paulschow/epapercard/README.md

# epapercard
Design for a epaper business card

Project writeup http://www.paulschow.com/2016/08/epaper-business-card.html

Based on the reference deisgns from http://repaper.org/

Requires MSP430 Launchpad to program.
