paulschow/epapercard/Brd_back_Aug14.png

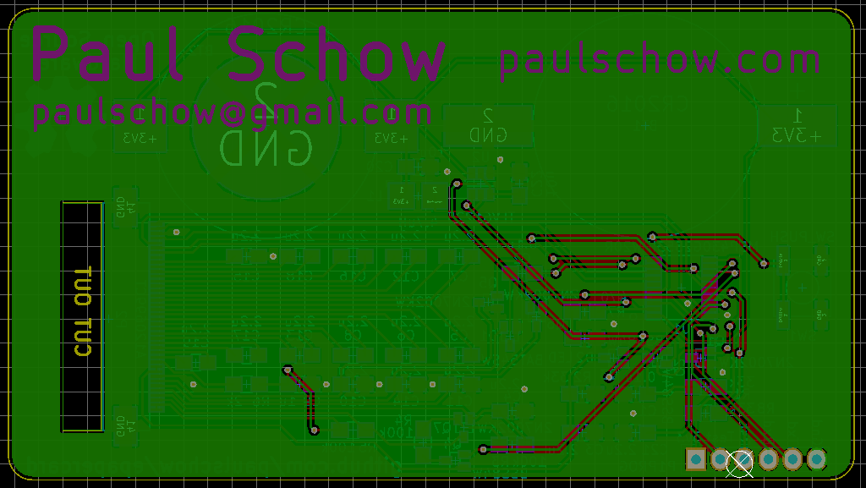
Brd_back_Aug14.png
