paulschow/epapercard/Brd_front_Aug14.png

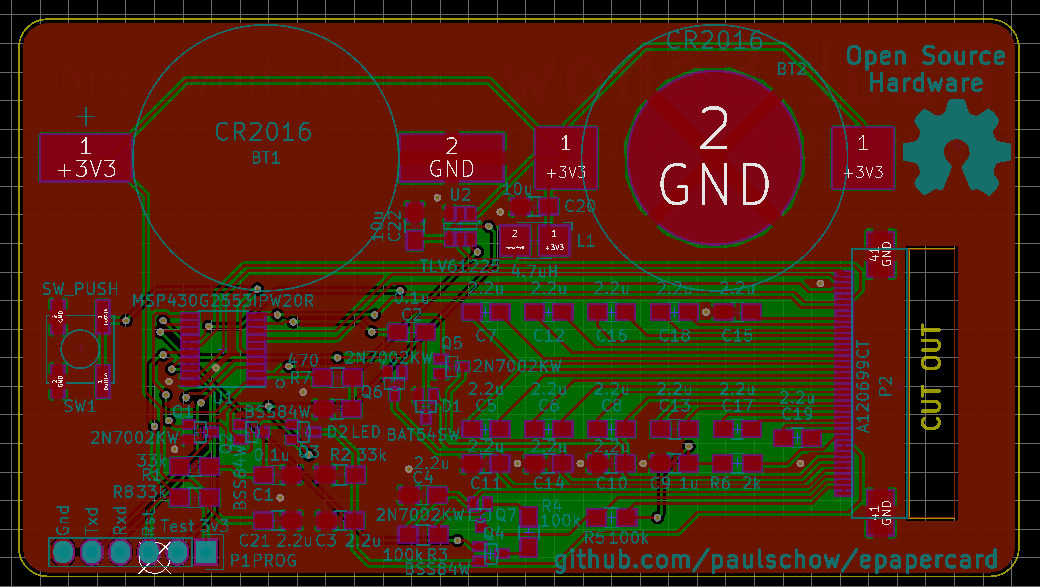
Brd_front_Aug14.png
