paulschow/epapercard/Sch_Aug_14.pdf

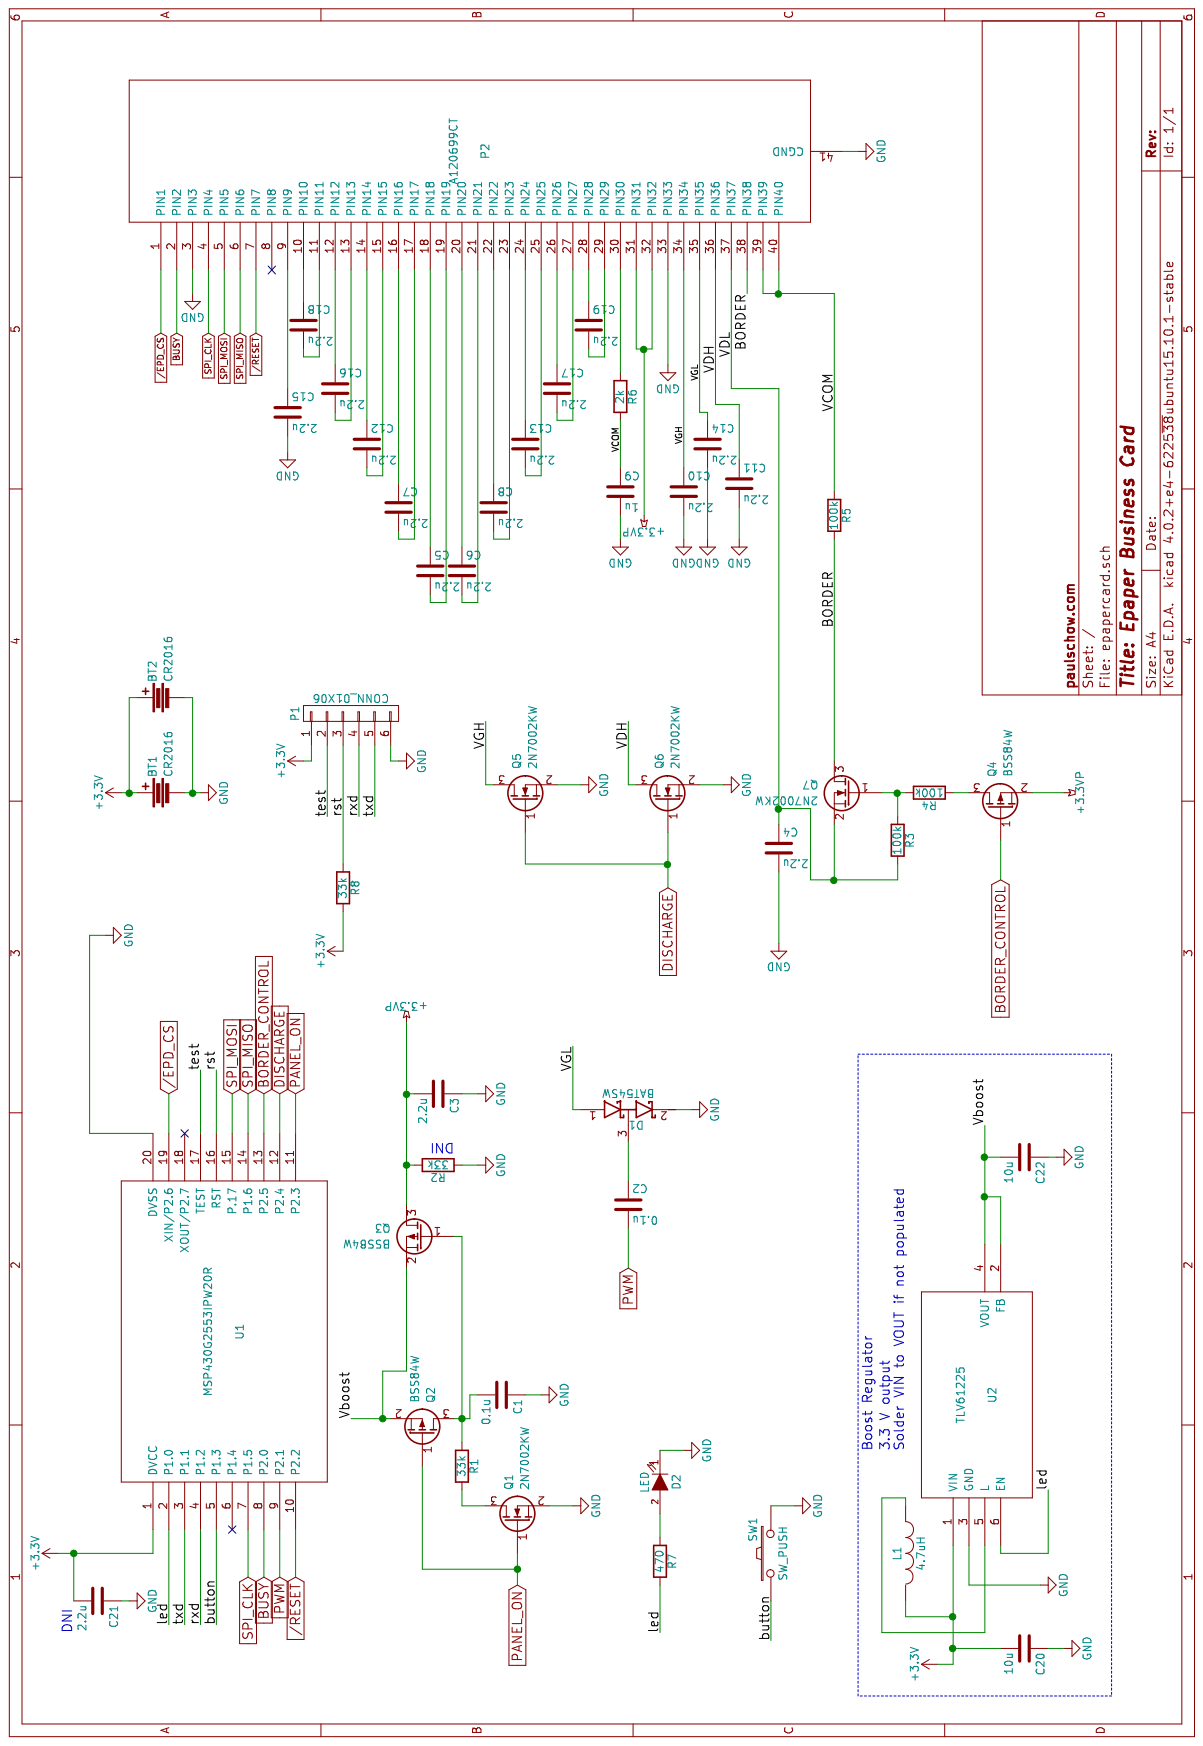
[picture p3: page 1]
