paulschow/epapercard/epapercard.kicad_pcb

## KiCad design epapercard.kicad_pcb (2016-08-05)

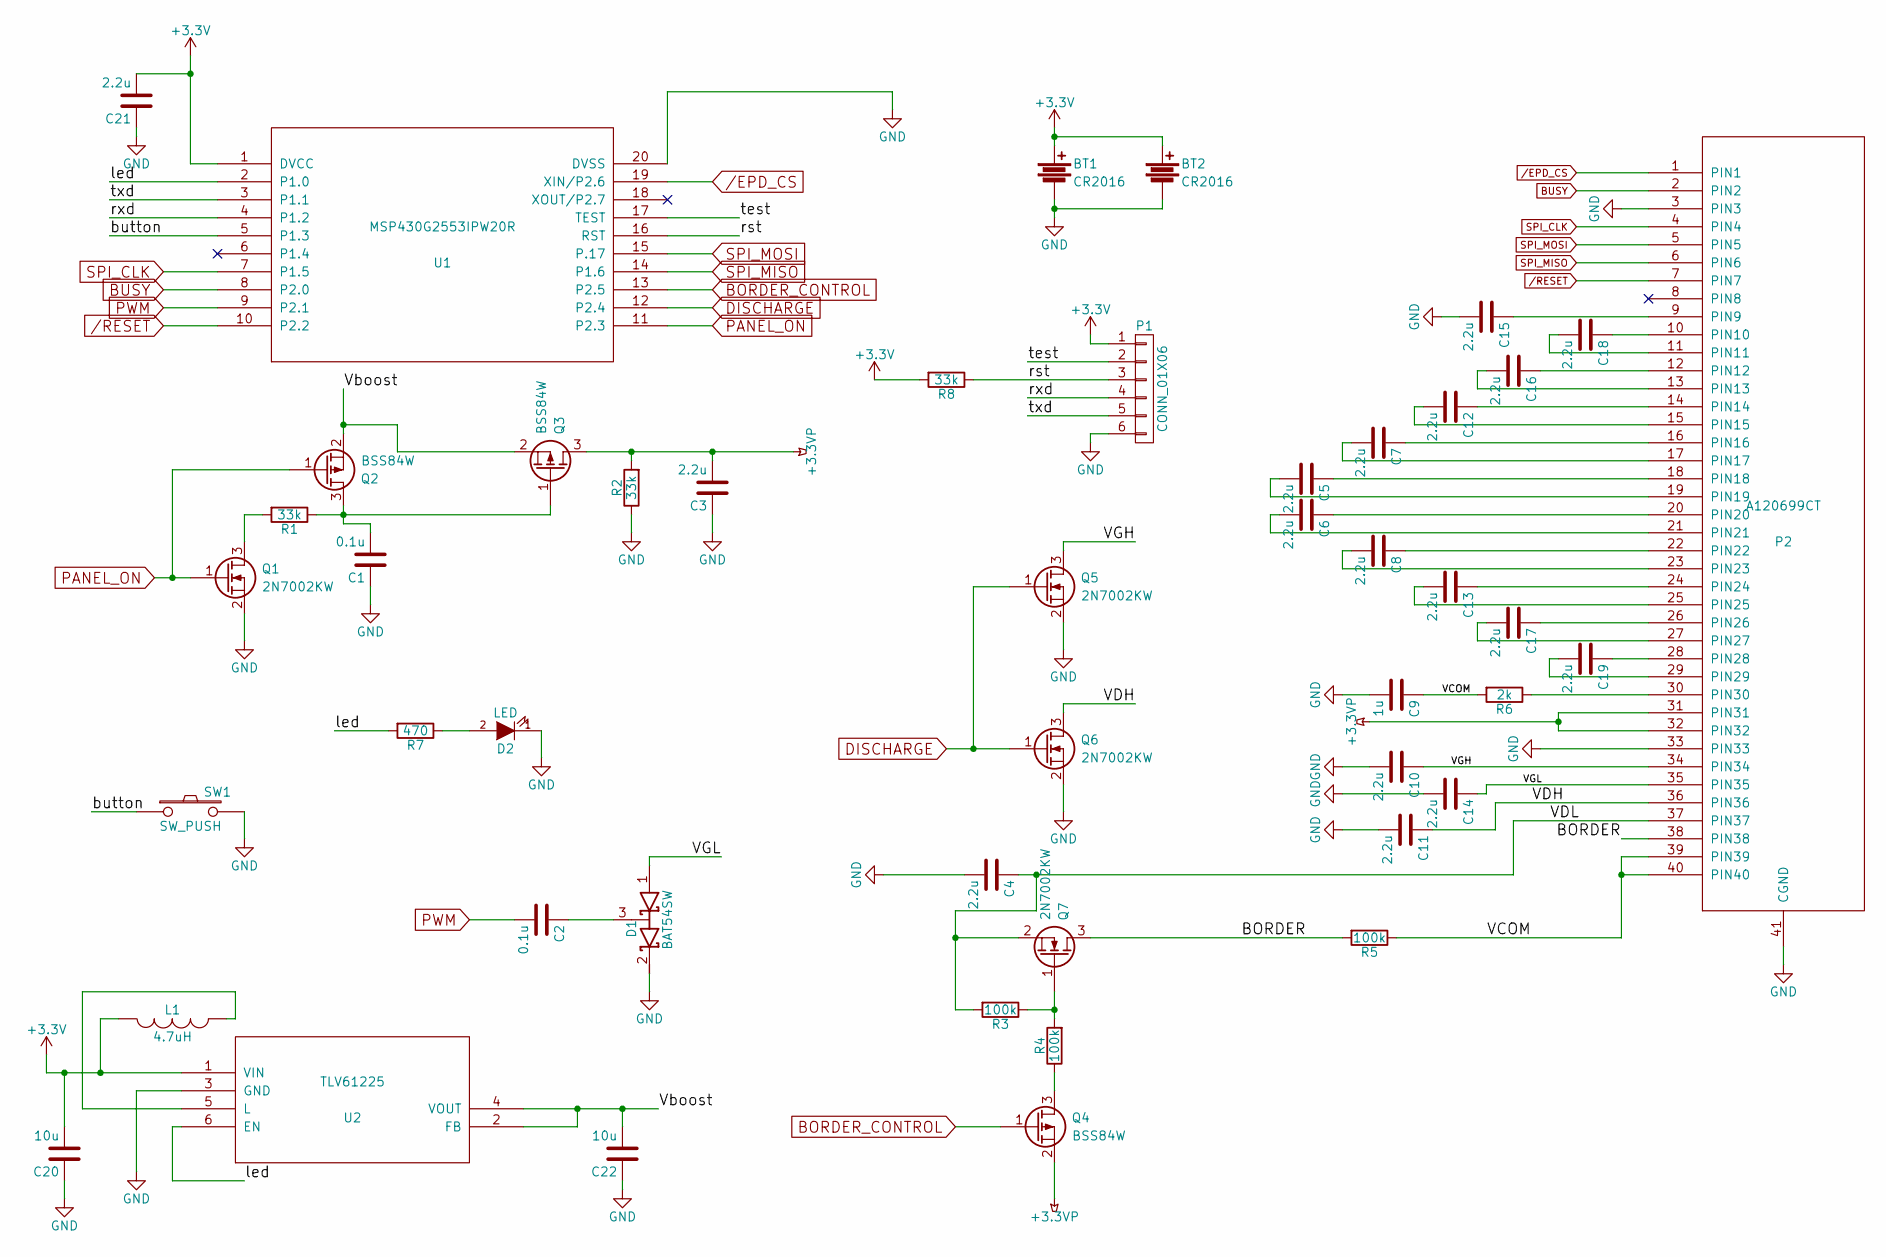
[picture p4: schematic epapercard.sch, Epaper Business Card]

Parts:
BT1: CR2016; CR2016sm-F2N
BT2: CR2016; CR2032sm
C1, C2: 0.1u; C_0805_HandSoldering
C3, C4, C5, C6, C7, C8, C10, C11, C12, C13, C14, C15, C16, C17, C18, C19, C21: 2.2u; C_0805_HandSoldering
C9: 1u; C_0805_HandSoldering
C20, C22: 10u; C_0805_HandSoldering
D1: BAT54SW; SOT-323
D2: LED; C_0805_HandSoldering
L1: 4.7uH; Inductor_1212
P1: CONN_01X06; Pin_Header_Straight_1x06
P2: A120699CT
Q1, Q5, Q6, Q7: 2N7002KW; SOT-323
Q2, Q3, Q4: BSS84W; SOT-323
R1, R2, R8: 33k; R_0805_HandSoldering
R3, R4, R5: 100k; R_0805_HandSoldering
R6: 2k; R_0805_HandSoldering
R7: 470; R_0805_HandSoldering
SW1: SW_PUSH; SW_SPST_EVPBF
U1: MSP430G2553IPW20R; TSSOP-20_4.4x6.5mm_Pitch0.65mm
U2: TLV61225; SOT-23-6

Connections:
+3.3VP: C3.2, P2.31 (PIN31), P2.32 (PIN32), Q3.3 (D), Q4.2 (S), R2.2
+3V3: BT1.1, BT2.1, C20.2, C21.2, L1.1, P1.1, R8.2, U1.1 (DVCC), U2.1 (VIN)
/BORDER: P2.38 (PIN38), Q7.3 (D), R5.2
/EPD_CS: P2.1 (PIN1), U1.19 (XIN/P2.6)
/RESET: P2.7 (PIN7), U1.10 (P2.2)
/VCOM: C9.1, P2.39 (PIN39), P2.40 (PIN40), R5.1, R6.2
/VDH: C11.1, P2.36 (PIN36), Q6.3 (D)
/VDL: C4.1, P2.37 (PIN37), Q7.2 (S), R3.2
/VGH: C10.1, P2.34 (PIN34), Q5.3 (D)
/VGL: C14.1, D1.1 (A), P2.35 (PIN35)
/Vboost: C22.2, Q2.2 (S), Q3.2 (S), U2.2 (FB), U2.4 (VOUT)
/button: SW1.1, U1.5 (P1.3)
/led: R7.2, U1.2 (P1.0), U2.6 (EN)
/rst: P1.3, R8.1, U1.16 (RST)
/rxd: P1.4, U1.4 (P1.2)
/test: P1.2, U1.17 (TEST)
/txd: P1.5, U1.3 (P1.1)
BORDER_CONTROL: Q4.1 (G), U1.13 (P2.5)
BUSY: P2.2 (PIN2), U1.8 (P2.0)
DISCHARGE: Q5.1 (G), Q6.1 (G), U1.12 (P2.4)
GND: BT1.2, BT2.2, C1.1, C3.1, C4.2, C9.2, C10.2, C11.2, C14.2, C15.2, C20.1, C21.1, C22.1, D1.2 (K), D2.1 (K), P1.6, P2.3 (PIN3), P2.33 (PIN33), P2.41 (CGND), Q1.2 (S), Q5.2 (S), Q6.2 (S), R2.1, SW1.2, U1.20 (DVSS), U2.3 (GND)
unnamed: C1.2, Q2.3 (D), Q3.1 (G), R1.1
unnamed: C2.1, D1.3 (common)
unnamed: C5.1, P2.18 (PIN18)
unnamed: C5.2, P2.19 (PIN19)
unnamed: C6.1, P2.20 (PIN20)
unnamed: C6.2, P2.21 (PIN21)
unnamed: C7.1, P2.16 (PIN16)
unnamed: C7.2, P2.17 (PIN17)
unnamed: C8.1, P2.22 (PIN22)
unnamed: C8.2, P2.23 (PIN23)
unnamed: C12.1, P2.14 (PIN14)
unnamed: C12.2, P2.15 (PIN15)
unnamed: C13.1, P2.24 (PIN24)
unnamed: C13.2, P2.25 (PIN25)
unnamed: C15.1, P2.9 (PIN9)
unnamed: C16.1, P2.12 (PIN12)
unnamed: C16.2, P2.13 (PIN13)
unnamed: C17.1, P2.26 (PIN26)
unnamed: C17.2, P2.27 (PIN27)
unnamed: C18.1, P2.10 (PIN10)
unnamed: C18.2, P2.11 (PIN11)
unnamed: C19.1, P2.28 (PIN28)
unnamed: C19.2, P2.29 (PIN29)
unnamed: D2.2 (A), R7.1
unnamed: L1.2, U2.5 (L)
unnamed: P2.30 (PIN30), R6.1
unnamed: Q1.3 (D), R1.2
unnamed: Q4.3 (D), R4.1
unnamed: Q7.1 (G), R3.1, R4.2
PANEL_ON: Q1.1 (G), Q2.1 (G), U1.11 (P2.3)
PWM: C2.2, U1.9 (P2.1)
SPI_CLK: P2.4 (PIN4), U1.7 (P1.5)
SPI_MISO: P2.6 (PIN6), U1.14 (P1.6)
SPI_MOSI: P2.5 (PIN5), U1.15 (P.17)

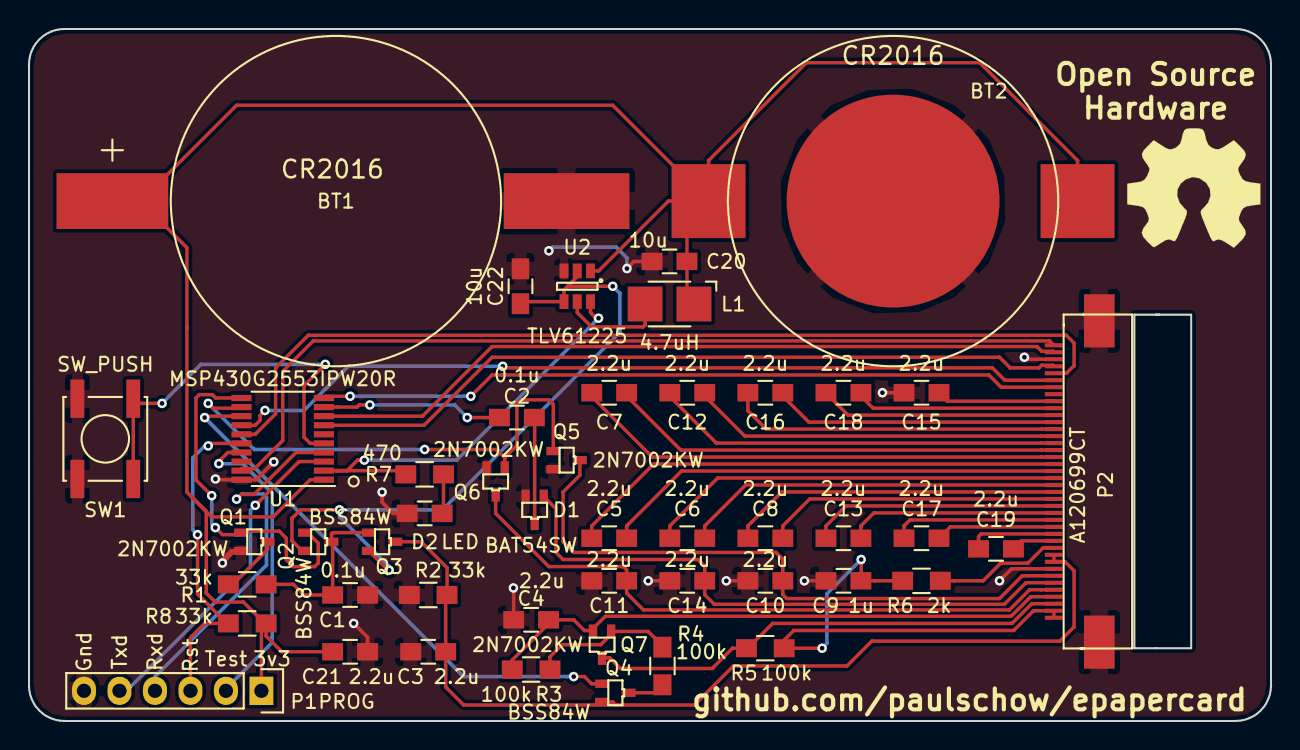
[picture p5: board epapercard.kicad_pcb from above]

Board: 2 copper layers, 88.9 x 49.5 mm, 47 parts (0 on the bottom side), 55 nets.
