paulschow/epapercard/(commit log)

2016-05-12 Adding new parts
    [epapercard.kicad_pcb, epapercard.sch]
2016-05-12 Microcontroller connections
    [epapercard.sch]
2016-05-12 Added charge pump caps
    [epapercard.sch]
2016-05-12 I figure out how to use kicad again
2016-05-12 Fixed a few mistakes
    [epapercard.sch]
2016-05-12 Added power circuit
    [epapercard.sch]
2016-05-12 Fixed some labels
    [epapercard.sch]
2016-05-13 Added programming circuit
    [epapercard.sch]
2016-05-13 Attached footprints
    [epapercard.sch]
2016-05-13 Laying board out
    [epapercard.kicad_pcb, epapercard.sch]
2016-05-13 I remembered how mirrors work
    [epapercard.kicad_pcb]
2016-05-13 Switched to surface mount battery holders
    [epapercard.kicad_pcb, epapercard.sch]
2016-05-13 Minor tweaks
    [epapercard.kicad_pcb]
2016-05-13 Connected everything
    [epapercard.kicad_pcb]
2016-05-13 Fixed silk
    [epapercard.kicad_pcb]
2016-05-13 More silk changes
    [epapercard.kicad_pcb]
2016-05-13 Added OSHW logo
    [epapercard.kicad_pcb]
2016-05-13 Generated gerbers
    [epapercard-B.Cu.gbl, epapercard-B.Mask.gbs, epapercard-B.SilkS.gbo, epapercard-Edge.Cuts.gm1, epapercard-F.Cu.gtl, epapercard-F.Mask.gts, epapercard-F.SilkS.gto, epapercard.drl]
2016-05-13 Updated silk
    [epapercard.kicad_pcb]
2016-05-13 New gerbers
    [epapercard-B.Cu.gbl, epapercard-B.Mask.gbs, epapercard-B.SilkS.gbo, epapercard-Edge.Cuts.gm1, epapercard-F.Cu.gtl, epapercard-F.Mask.gts, epapercard-F.SilkS.gto, epapercard.drl]
2016-05-16 Generated BOM
    [epapercard.csv, epapercard.sch]
2016-05-27 Changed fet position
    [epapercard.sch]
2016-05-31 Fixed pin numbering
2016-05-31 Adjusting footprints
    [epapercard.kicad_pcb, epapercard.sch]
2016-05-31 Extended ground pads
2016-05-31 Basically starting over
    [epapercard.kicad_pcb]
2016-05-31 Routed caps
    [epapercard.kicad_pcb, epapercard.sch]
2016-05-31 Placed all components
    [epapercard.kicad_pcb]
2016-05-31 All routed
    [epapercard.kicad_pcb]
2016-06-04 New BOM
    [epapercard.csv]
2016-06-04 Added digikey part numbers
    [epapercard.csv]
2016-06-17 Updated working firmware w/o interrupts
2016-07-06 Low power mode interrupt working
2016-07-06 Added LED back
2016-07-06 Added CR2016 footprint
    [epapercard.sch]
2016-07-06 Changed battery footprint
    [epapercard.kicad_pcb, epapercard.sch]
2016-07-06 Adjusted dimensions
    [epapercard.kicad_pcb]
2016-07-07 Added boost regulator
    [epapercard-B.Cu.gbl, epapercard-B.Mask.gbs, epapercard-B.SilkS.gbo, epapercard-Edge.Cuts.gm1, epapercard-F.Cu.gtl, epapercard-F.Mask.gts, epapercard-F.Paste.gtp, epapercard-F.SilkS.gto]
2016-07-13 Changing CR2016 footprint to one with tabs
2016-07-13 Add tabbed battery and boost reg
    [epapercard.kicad_pcb, epapercard.sch]
2016-07-13 Move a few tracks around
    [epapercard.kicad_pcb]
2016-07-13 Everything connected
    [epapercard.kicad_pcb, epapercard.sch]
2016-07-13 Silk cleanup
    [epapercard.kicad_pcb]
2016-08-05 Fixed TLV61225 footprint
    [epapercard.kicad_pcb, epapercard.sch]
2016-08-14 Fixed boost regulator
    [epapercard.sch]
2016-08-14 Generate BOM
    [epapercard.csv]
2016-08-14 Updated BOMs
    [epapercard.csv, epapercard_bom_digikey.csv, epapercard_grouped.csv]
2016-08-14 Make github happy
    [epapercard_bom_digikey.csv]
2016-08-14 Updated BOM
    [epapercard_grouped.csv]
2016-08-14 Added schematic and board pictures
